robotronik/cdfr2023-Carte-led_interrupteur-CDFR/Carte led V2.0/Carte led_interrupteur CDFR.kicad_pcb

## KiCad design Carte led V2.0/Carte led_interrupteur CDFR.kicad_pcb (2023-04-18)

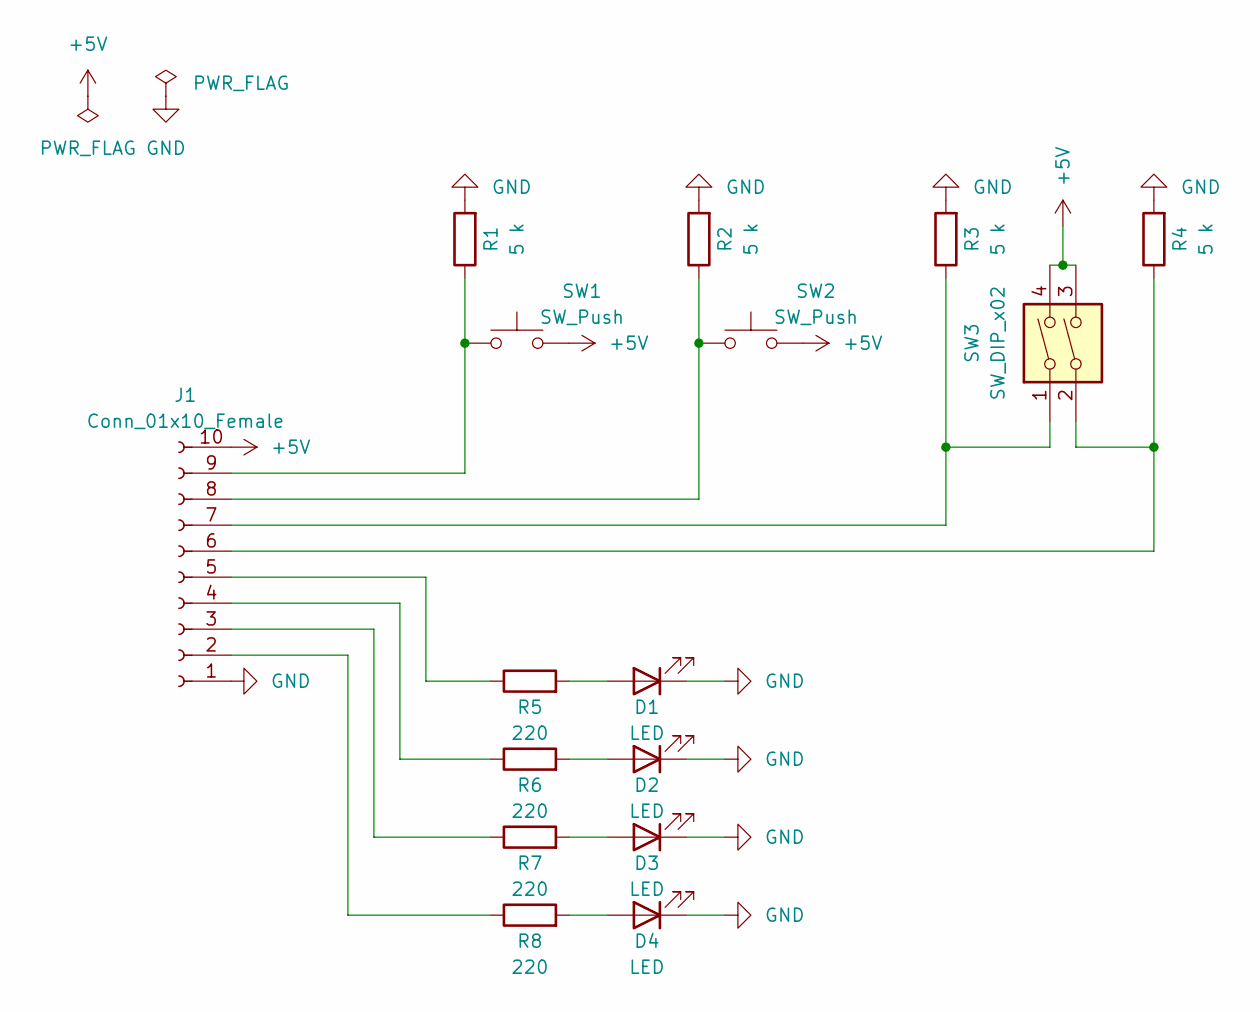
[picture p1: schematic Carte led_interrupteur CDFR.kicad_sch]

Parts:
D1, D2, D3, D4: LED; LED_D3.0mm
J1: Conn_01x10_Female; PinHeader_2x05_P2.54mm_Vertical
R1, R2, R3, R4: 5 k; R_Axial_DIN0207_L6.3mm_D2.5mm_P10.16mm_Horizontal
R5, R6, R7, R8: 220; R_Axial_DIN0207_L6.3mm_D2.5mm_P10.16mm_Horizontal
SW1, SW2: SW_Push; SW_PUSH_6mm_H7.3mm
SW3: SW_DIP_x02; SW_DIP_SPSTx02_Slide_9.78x7.26mm_W7.62mm_P2.54mm

Connections:
+5V: J1.10, SW1.2, SW2.2, SW3.3, SW3.4
GND: D1.1 (K), D2.1 (K), D3.1 (K), D4.1 (K), J1.1, R1.2, R2.2, R3.2, R4.2
unnamed: D1.2 (A), R5.2
unnamed: D2.2 (A), R6.2
unnamed: D3.2 (A), R7.2
unnamed: D4.2 (A), R8.2
unnamed: J1.2, R8.1
unnamed: J1.3, R7.1
unnamed: J1.4, R6.1
unnamed: J1.5, R5.1
unnamed: J1.6, R4.1, SW3.2
unnamed: J1.7, R3.1, SW3.1
unnamed: J1.8, R2.1, SW2.1
unnamed: J1.9, R1.1, SW1.1

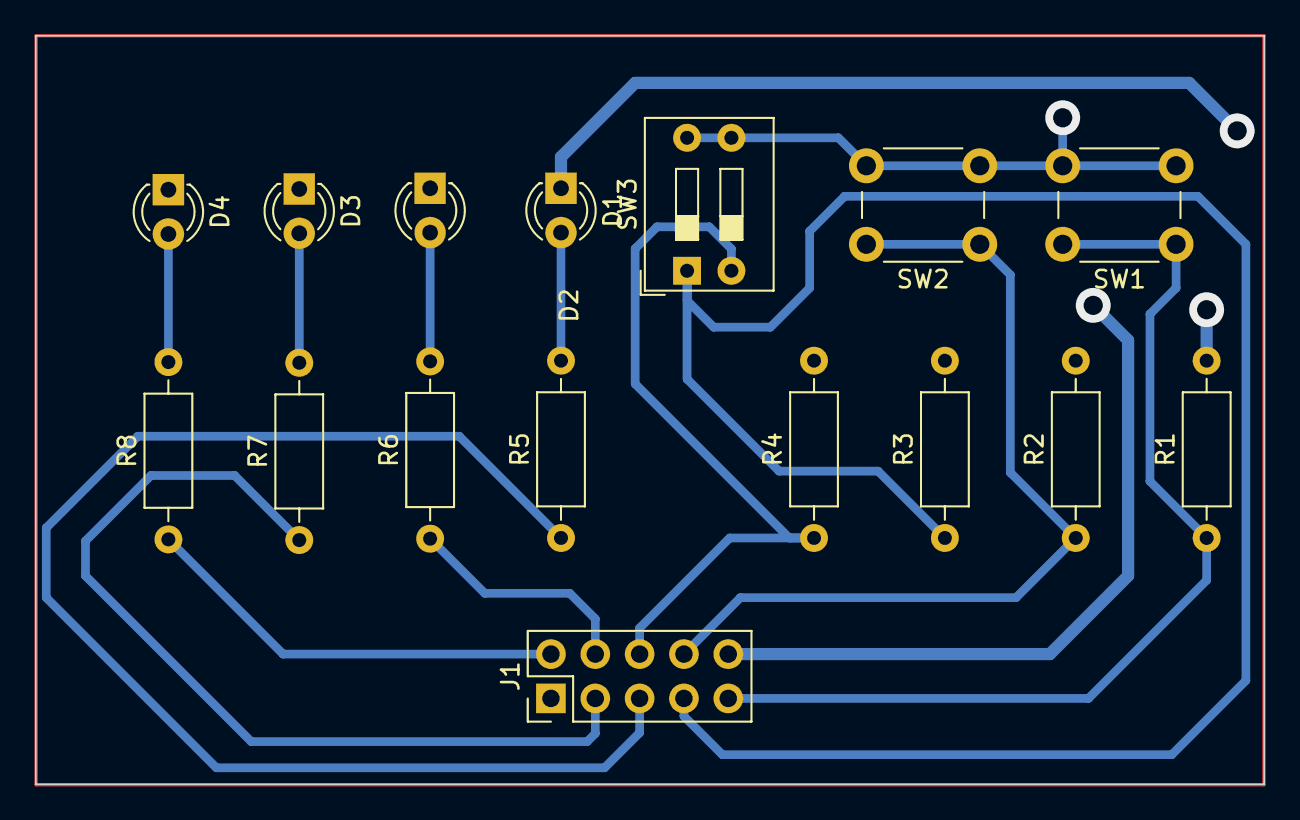
[picture p2: board Carte led_interrupteur CDFR.kicad_pcb from above]

Board: 2 copper layers, 70.4 x 42.9 mm, 16 parts (0 on the bottom side), 14 nets.
