robotronik/cdfr2023-Carte-led_interrupteur-CDFR/(commit log)

2023-04-09 change pin header
    [Carte led_interrupteur CDFR.kicad_pcb, Carte led_interrupteur CDFR.kicad_sch]
2023-04-18 mise à jour pin header 2x5
    [Carte led_interrupteur CDFR.kicad_pcb, Carte led_interrupteur CDFR.kicad_sch]
